gitcfyang/DIY-Sim-Racing-System/SimWheeling/BOM.xlsx

 | 物料 | 型号 | 数量 | 链接 |  | 价格（参考） | 备注
主体 | 碳纤维板加工 |  | 4 |  |  | 160
 | 3d打印件 |  | 若干 |  |  | 30
 | 快拆 | 尺寸适配即可 | 1 |  |  | 50
电子元件 | 按钮（12mm） | pbs-33b | 12 |  |  | 14.4
 | 旋钮（大扭力） | ec11（15mm，200-250g，16脉冲16位，半圆柄） | 5 |  |  | 32.5
 | 微动开关 | d2f-01l（可以使用更便宜的，孔间距6.5mm即可） | 2 |  |  | 5.16
 | 树莓派pico | 无需焊接 | 1 |  |  | 9.75
 | mcp23017模块 |  | 1 |  |  | 10.8
 | 电线 | 24awg硅胶线 | 10m |  |  | 6.8
 | typec数据线 |  | 1 |  |  | 0 | 找一条旧的即可，连接树莓派pico与航空插头
 | 航空插头 | gx12-4p | 1 |  |  | 1.66
 | 赛车弹簧航插线 |  | 1 |  |  | 28 | 闲鱼搜索购买
螺丝螺母（均为内六角，黑色） | m5*65圆头 |  | 3 |  |  |  | 快拆固定螺丝
最好要有冗余！！ | m5*25杯头 |  | 6 |  |  |  | 握把固定螺丝
 | m4*30圆头 |  | 4 |  |  |  | 拨片换挡器固定螺丝
 | m3*18沉头 |  | 6 |  |  |  | 按钮装饰及后盖固定螺丝
 | m2.5*20圆头 |  | 4 |  |  |  | 电路板固定螺丝
 | m4*40 |  | 2 |  | 螺丝总计 | 50 | 换挡拨片用
 | m3*5 |  | 4 |  |  |  | 换挡拨片用
 | m2*14 |  | 4 |  |  |  | 换挡拨片固定微动开关
 | m4*6紧定螺丝 |  | 5 |  |  |  | 旋钮固定螺丝
 | m5尼龙螺母 |  | 若干
 | m4尼龙螺母 |  | 若干
 | m3尼龙螺母 |  | 若干
 | m3普通螺母 |  | 若干
 | m2.5尼龙螺母 |  | 若干
 | m2螺母 |  | 若干
 | 5*9*0.5垫圈 |  | 若干 |  |  |  | 若干用途
其他 | 磁铁 | 直径10，厚度5-10 | >=4，可叠加增强磁性 |  |  | 10 | 换挡拨片用
 | 502 |  |  |  |  | 2 | 粘接磁铁和个别零件
 | 3m双面胶 | 15mm宽，薄款 |  |  |  | 10 | 粘接握把与碳板，填补空隙
 | 羽毛球手胶 |  |  |  |  | 10
 | 其他工具等等
总价 |  |  |  |  |  | 431.07
