gitcfyang/DIY-Sim-Racing-System/SimBase/PrintedComponents/Shell x1.stl

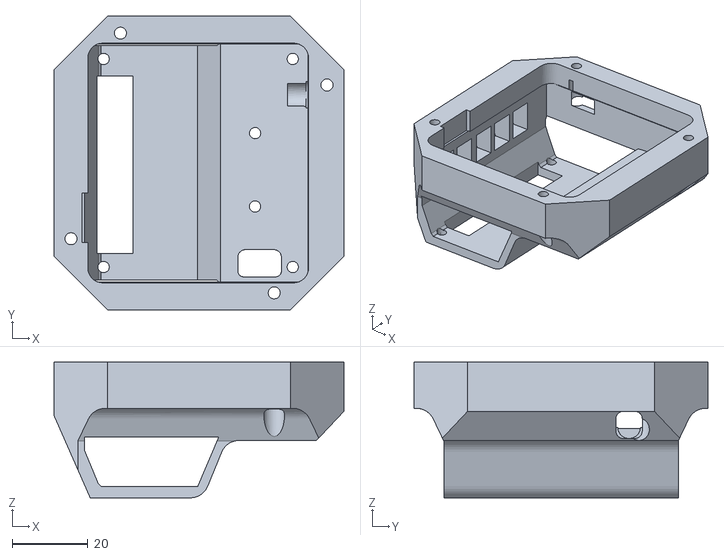
[picture p2: CAD file, 2026-06-08]
SimBase/PrintedComponents/Shell x1.stl
76.7 x 77.7 x 35.9
