gitcfyang/DIY-Sim-Racing-System/SimPedal/MetalComponents/Aluminium Pedal Plates/2mm Throttle Pedal Plate Sheet Metal.DXF

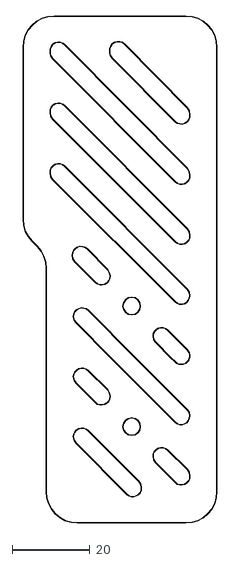
[picture p3: CAD file, 2026-06-08]
SimPedal/MetalComponents/Aluminium Pedal Plates/2mm Throttle Pedal Plate Sheet Metal.DXF
50.0 x 130.8
