gitcfyang/DIY-Sim-Racing-System/SimPedal/MetalComponents/Steel Parts/2mm Foot Plate x1.STEP

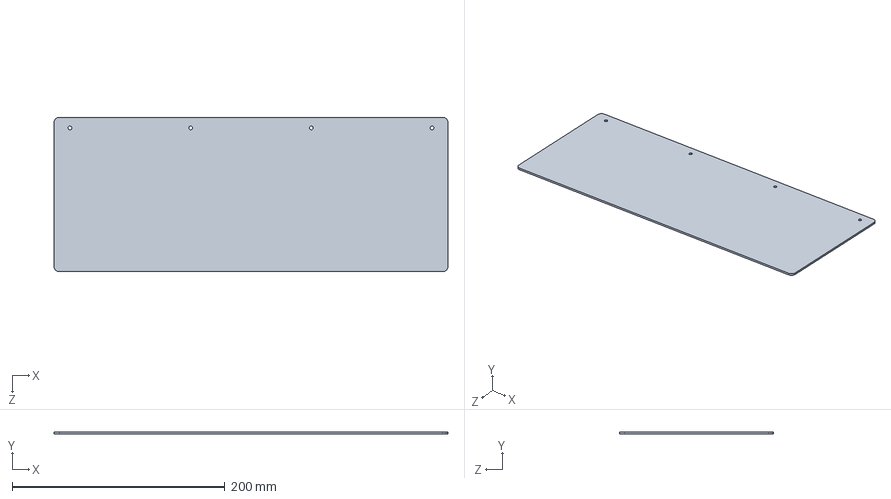
[picture p4: CAD file, 2026-06-08]
SimPedal/MetalComponents/Steel Parts/2mm Foot Plate x1.STEP
370.0 x 2.00 x 145.0 mm
