gitcfyang/DIY-Sim-Racing-System/SimPedal/PrintedComponents/ControlBox控制盒/ShellBase x1.stl

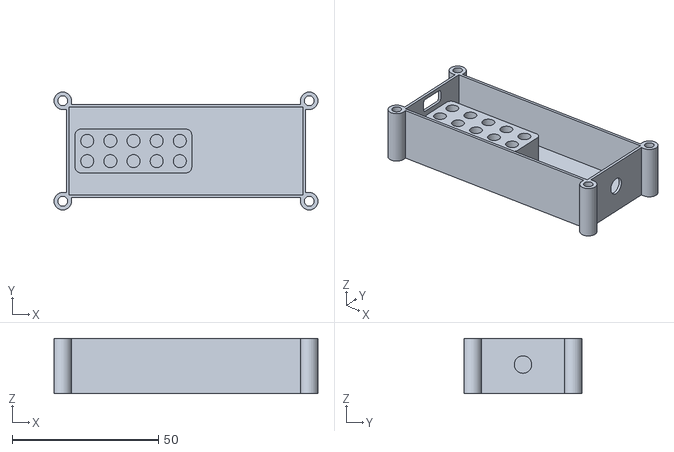
[picture p5: CAD file, 2026-06-08]
SimPedal/PrintedComponents/ControlBox控制盒/ShellBase x1.stl
90.4 x 40.4 x 19.0
