gitcfyang/DIY-Sim-Racing-System/SimPedal/PrintedComponents/Slide Bush x6.STL

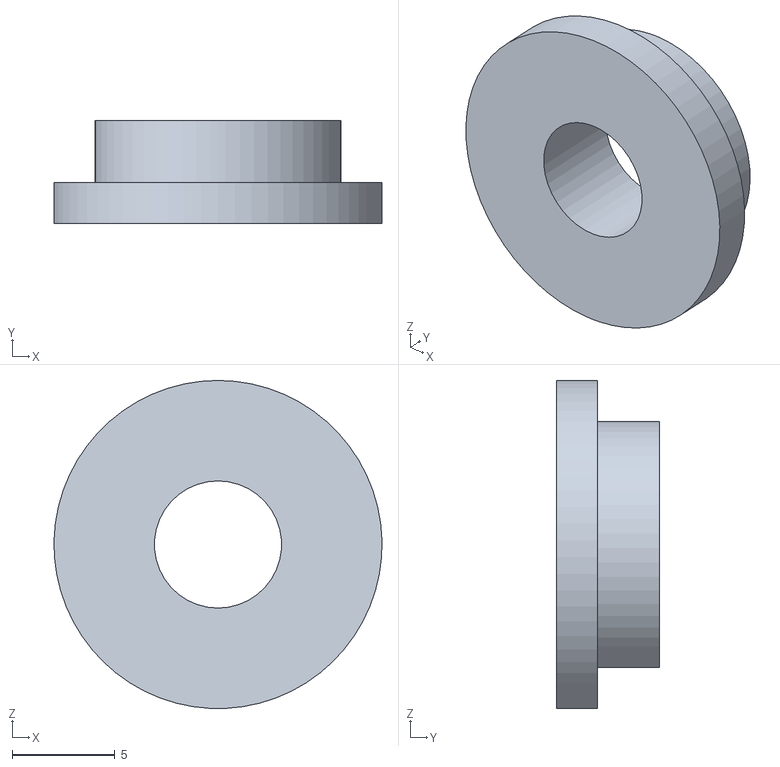
[picture p6: CAD file, 2026-06-08]
SimPedal/PrintedComponents/Slide Bush x6.STL
16.0 x 5.00 x 16.0
