gitcfyang/DIY-Sim-Racing-System/SimWheeling/PrintedComponents/Knob旋钮/Rotary Encoder Knob x5.stl

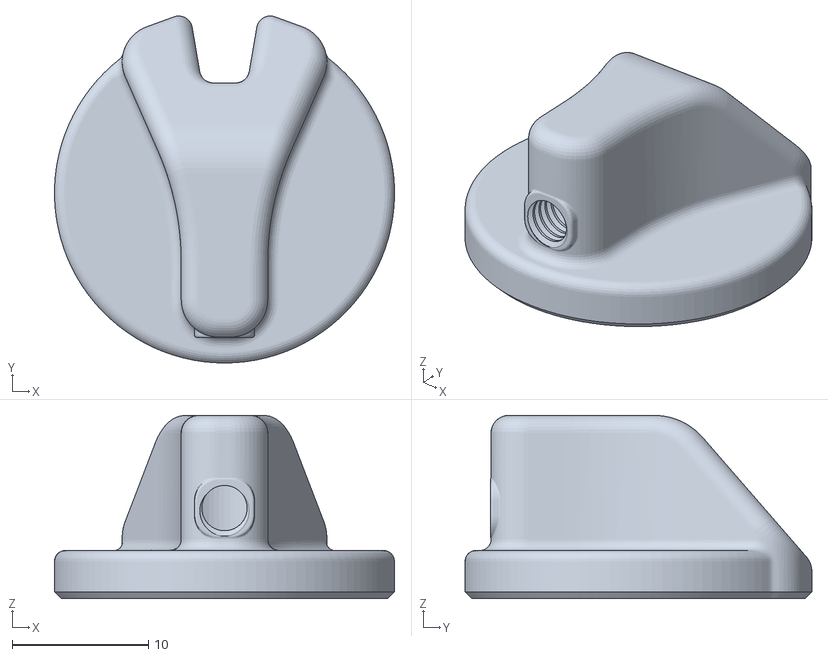
[picture p7: CAD file, 2026-06-08]
SimWheeling/PrintedComponents/Knob旋钮/Rotary Encoder Knob x5.stl
25.0 x 25.5 x 13.5
