gitcfyang/DIY-Sim-Racing-System/SimWheeling/PrintedComponents/Right Rear Button Cover x1.stl

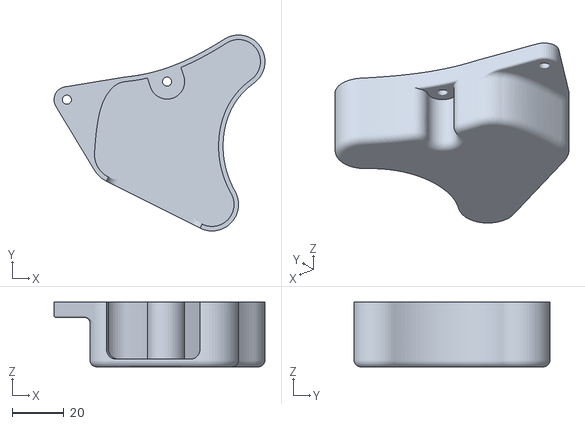
[picture p8: CAD file, 2026-06-08]
SimWheeling/PrintedComponents/Right Rear Button Cover x1.stl
81.5 x 75.7 x 25.0
