gitcfyang/DIY-Sim-Racing-System/SimWheeling/PrintedComponents/Shifter换挡拨片/Shifter Spacer x2.stl

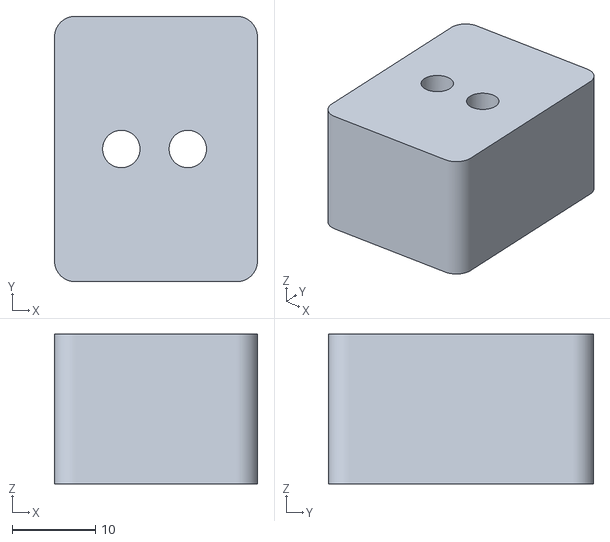
[picture p9: CAD file, 2026-06-08]
SimWheeling/PrintedComponents/Shifter换挡拨片/Shifter Spacer x2.stl
24.4 x 31.9 x 18.0
