gitcfyang/DIY-Sim-Racing-System/SimPedal/MetalComponents/Aluminium Pedal Plates/2mm Brake & Clutch Pedal Plate Sheet Metal.DXF

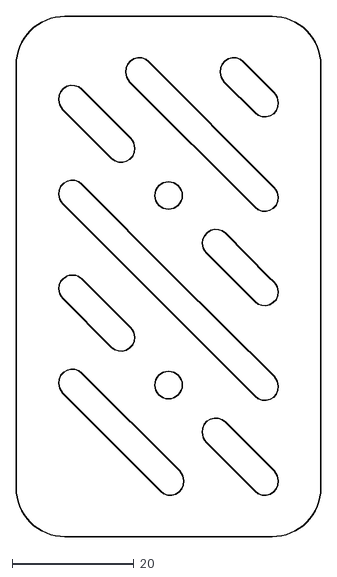
[picture p10: CAD file, 2026-06-08]
SimPedal/MetalComponents/Aluminium Pedal Plates/2mm Brake & Clutch Pedal Plate Sheet Metal.DXF
50.0 x 85.4
