gitcfyang/DIY-Sim-Racing-System/SimPedal/MetalComponents/Steel Parts/3mm Pedal Base Plate x3.STEP

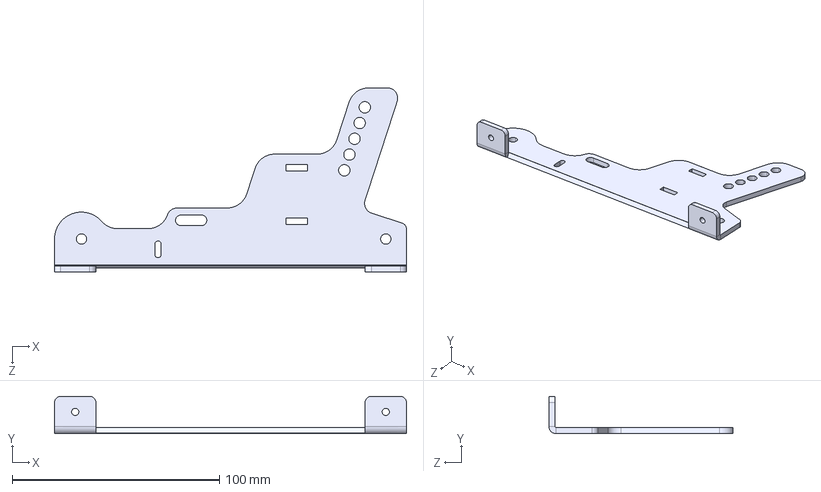
[picture p11: CAD file, 2026-06-08]
SimPedal/MetalComponents/Steel Parts/3mm Pedal Base Plate x3.STEP
170.0 x 18.0 x 89.0 mm
