gitcfyang/DIY-Sim-Racing-System/SimPedal/PrintedComponents/Pedal Mount x2.STL

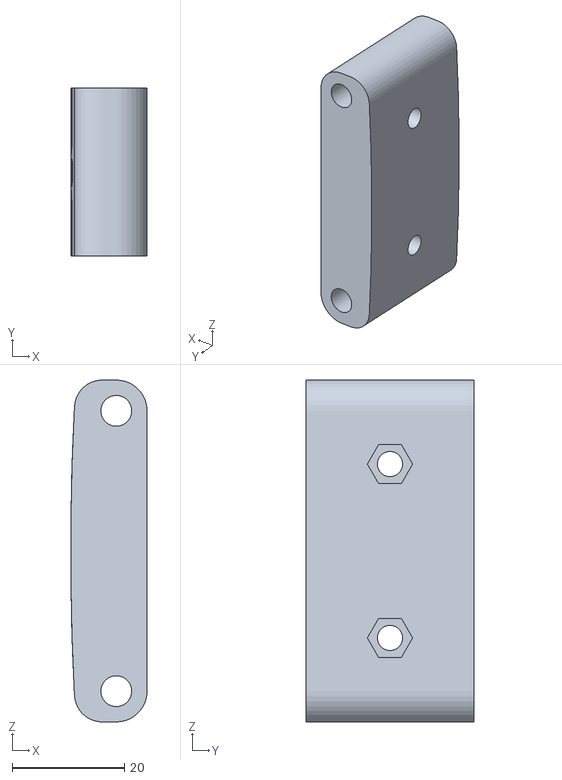
[picture p13: CAD file, 2026-06-08]
SimPedal/PrintedComponents/Pedal Mount x2.STL
13.6 x 30.0 x 61.0
