gitcfyang/DIY-Sim-Racing-System/SimWheeling/PrintedComponents/Grip Right Front x1.stl

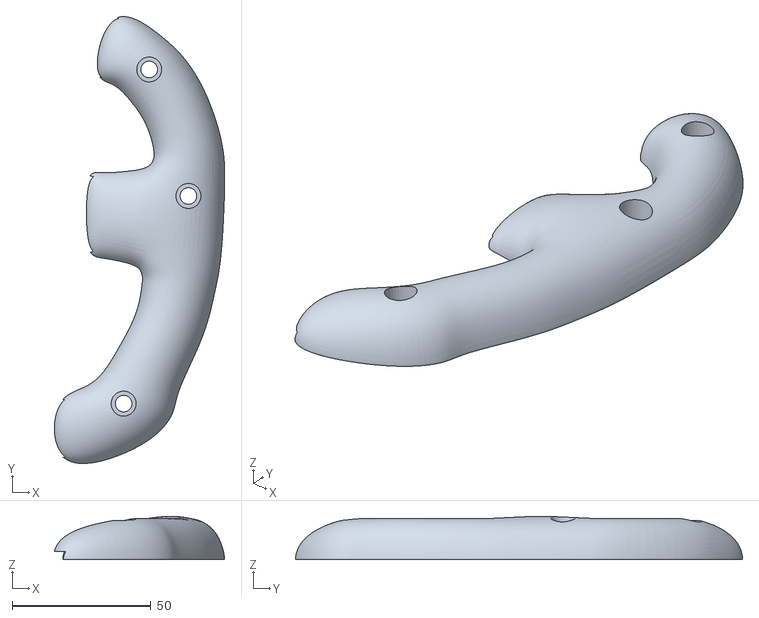
[picture p14: CAD file, 2026-06-08]
SimWheeling/PrintedComponents/Grip Right Front x1.stl
61.3 x 160.8 x 15.6
