gitcfyang/DIY-Sim-Racing-System/SimWheeling/PrintedComponents/Shifter换挡拨片/Base Top x2.stl

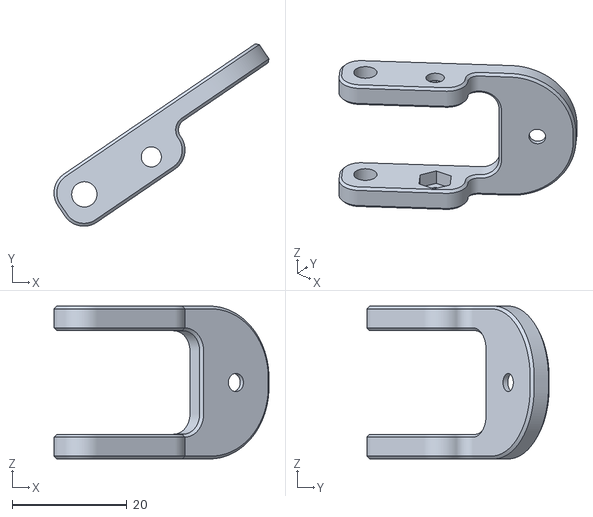
[picture p15: CAD file, 2026-06-08]
SimWheeling/PrintedComponents/Shifter换挡拨片/Base Top x2.stl
37.4 x 31.7 x 26.6
