gitcfyang/DIY-Sim-Racing-System/SimPedal/PrintedComponents/Pedal Bearing Mount x3.STL

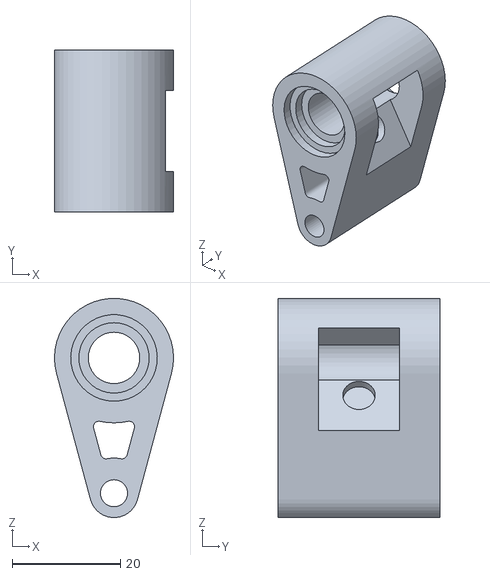
[picture p16: CAD file, 2026-06-08]
SimPedal/PrintedComponents/Pedal Bearing Mount x3.STL
22.0 x 30.0 x 40.5
