gitcfyang/DIY-Sim-Racing-System/SimWheeling/PrintedComponents/Hub Spacer x1.stl

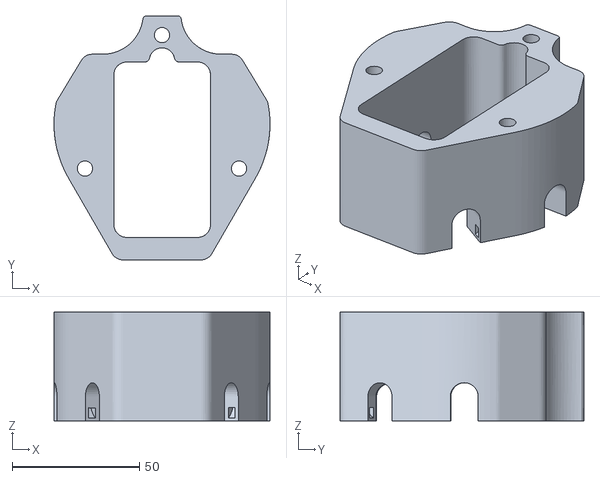
[picture p17: CAD file, 2026-06-08]
SimWheeling/PrintedComponents/Hub Spacer x1.stl
85.0 x 96.0 x 42.8
