gitcfyang/DIY-Sim-Racing-System/SimWheeling/PrintedComponents/Shifter换挡拨片/Lever x2.stl

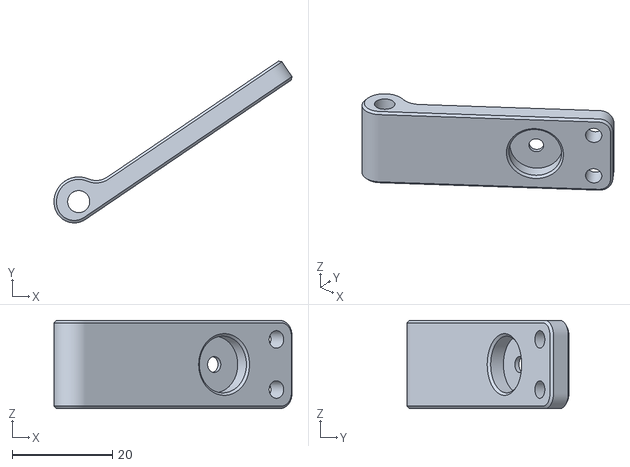
[picture p18: CAD file, 2026-06-08]
SimWheeling/PrintedComponents/Shifter换挡拨片/Lever x2.stl
47.4 x 32.3 x 17.6
