gitcfyang/DIY-Sim-Racing-System/SimPedal/MetalComponents/Steel Parts/3mm Load Cell Mounting Plate x2.STEP

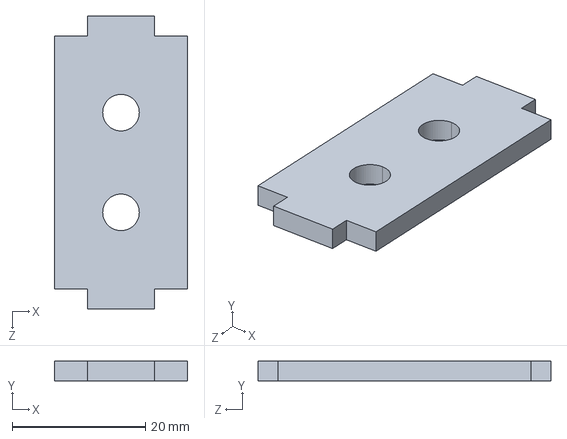
[picture p19: CAD file, 2026-06-08]
SimPedal/MetalComponents/Steel Parts/3mm Load Cell Mounting Plate x2.STEP
20.0 x 3.00 x 44.0 mm
