gitcfyang/DIY-Sim-Racing-System/SimPedal/PrintedComponents/Pedal Spacer x3.STL

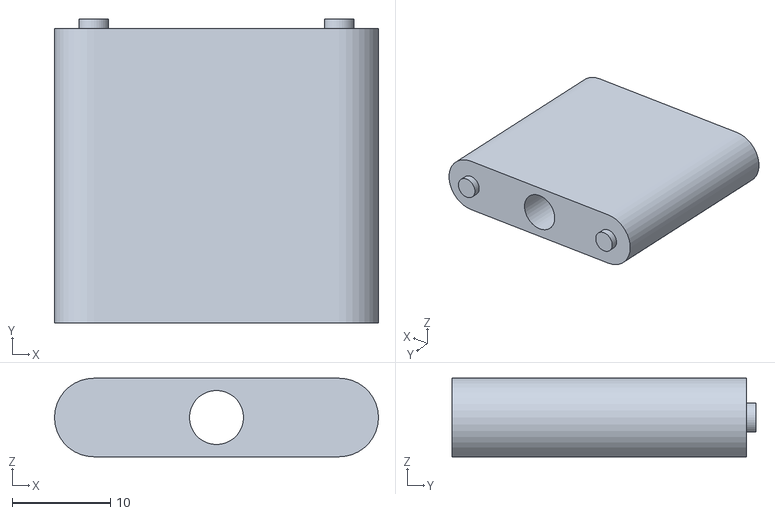
[picture p20: CAD file, 2026-06-08]
SimPedal/PrintedComponents/Pedal Spacer x3.STL
33.0 x 31.0 x 8.00
