gitcfyang/DIY-Sim-Racing-System/SimWheeling/PrintedComponents/Right Button Insert x1.stl

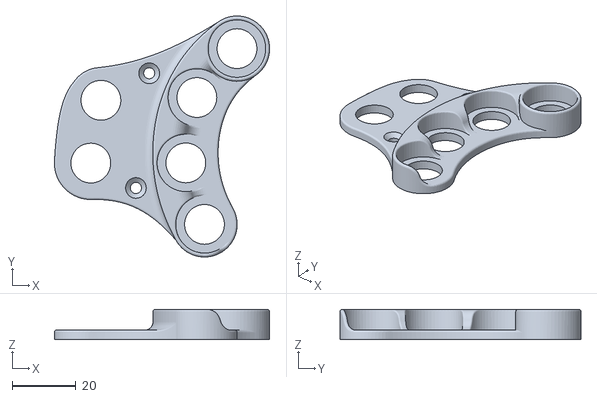
[picture p21: CAD file, 2026-06-08]
SimWheeling/PrintedComponents/Right Button Insert x1.stl
67.6 x 75.7 x 9.50
