gitcfyang/DIY-Sim-Racing-System/SimWheeling/PrintedComponents/Shifter换挡拨片/Base Bottom x2.stl

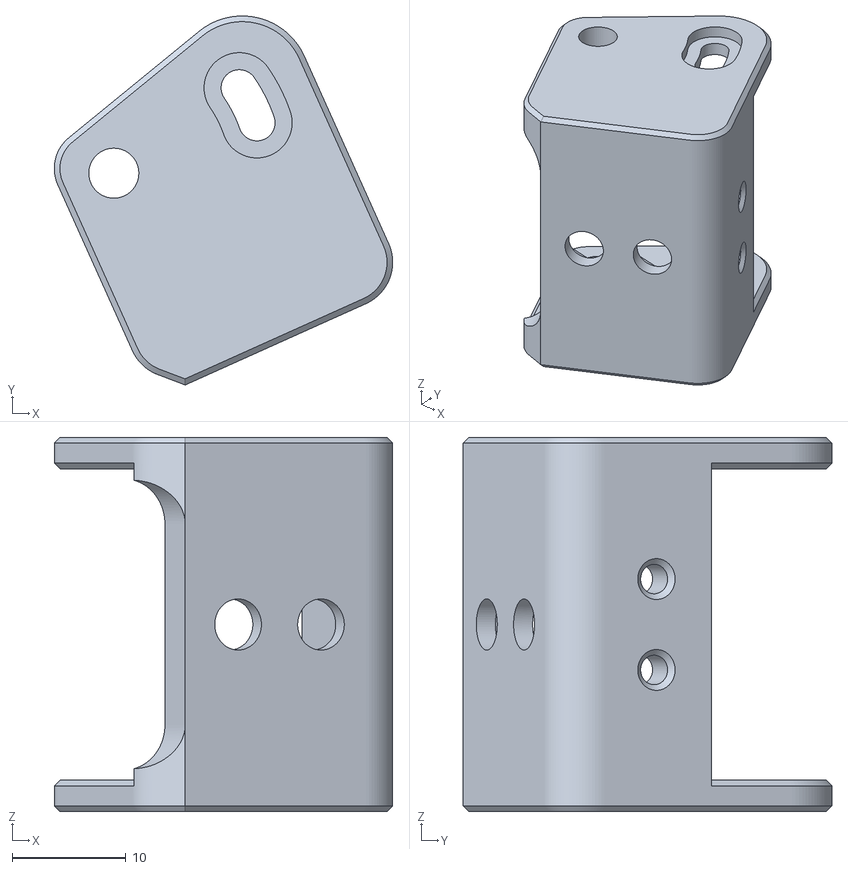
[picture p22: CAD file, 2026-06-08]
SimWheeling/PrintedComponents/Shifter换挡拨片/Base Bottom x2.stl
29.8 x 32.5 x 32.9
