gitcfyang/DIY-Sim-Racing-System/SimPedal/MetalComponents/Steel Parts/3mm Brake Spring Back Plate x1.STEP

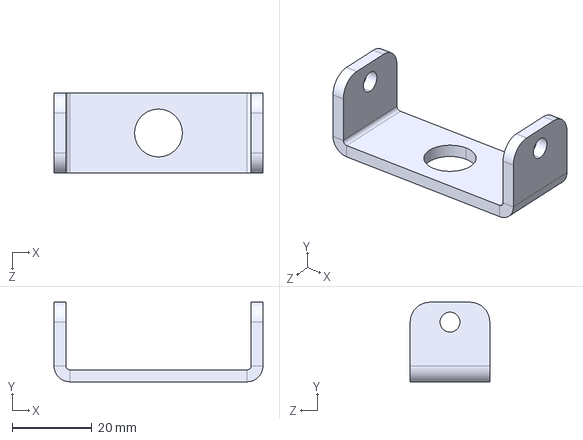
[picture p23: CAD file, 2026-06-08]
SimPedal/MetalComponents/Steel Parts/3mm Brake Spring Back Plate x1.STEP
52.5 x 20.0 x 20.0 mm
