gitcfyang/DIY-Sim-Racing-System/SimPedal/PrintedComponents/Foot Rest Support x1.stl

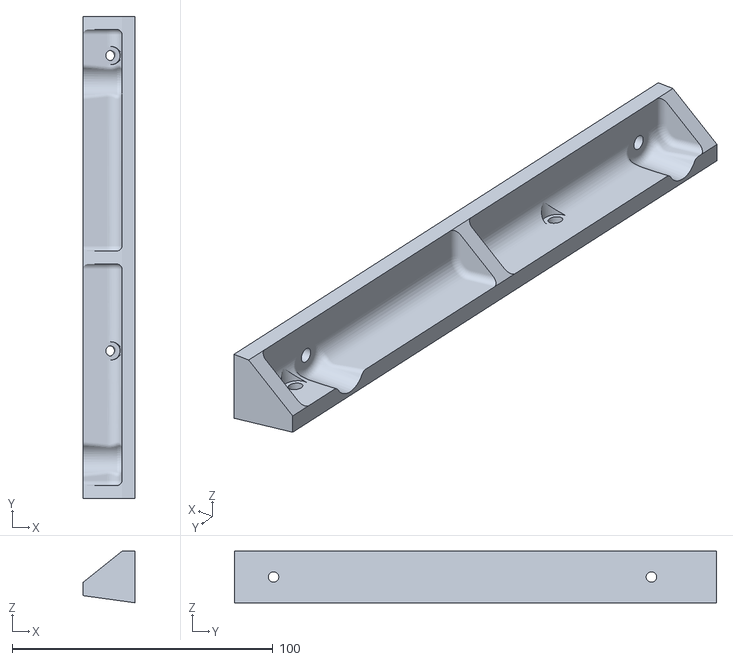
[picture p24: CAD file, 2026-06-08]
SimPedal/PrintedComponents/Foot Rest Support x1.stl
20.0 x 185.0 x 19.8
