gitcfyang/DIY-Sim-Racing-System/SimPedal/MetalComponents/Steel Parts/3mm Angled Load Cell Bracket x1.STEP

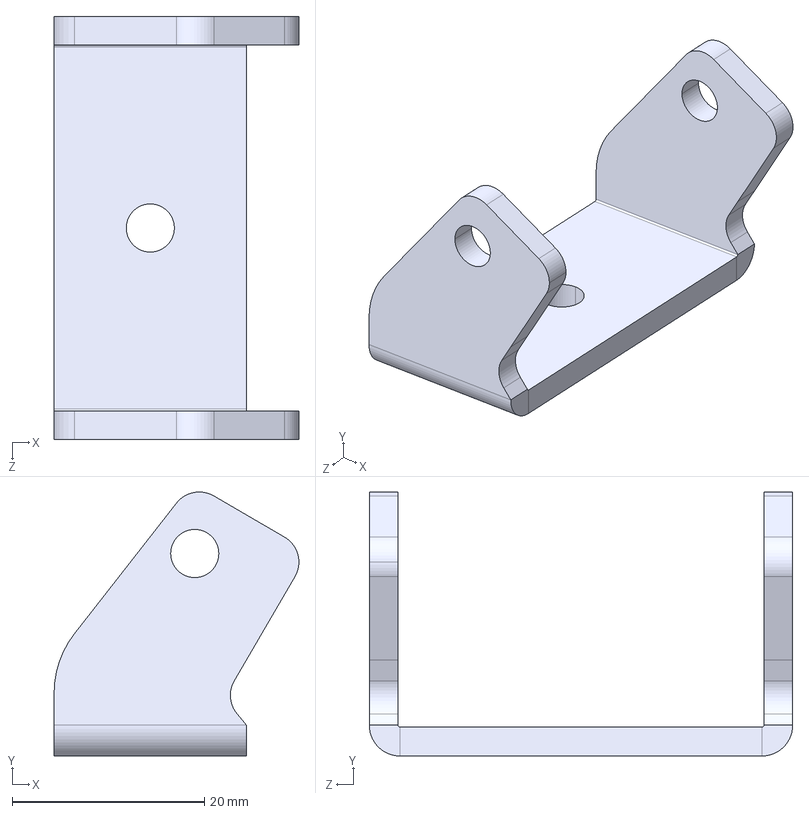
[picture p25: CAD file, 2026-06-08]
SimPedal/MetalComponents/Steel Parts/3mm Angled Load Cell Bracket x1.STEP
25.4 x 27.4 x 44.0 mm
