gitcfyang/DIY-Sim-Racing-System/SimPedal/PrintedComponents/Limit Stop Tube x6.STL

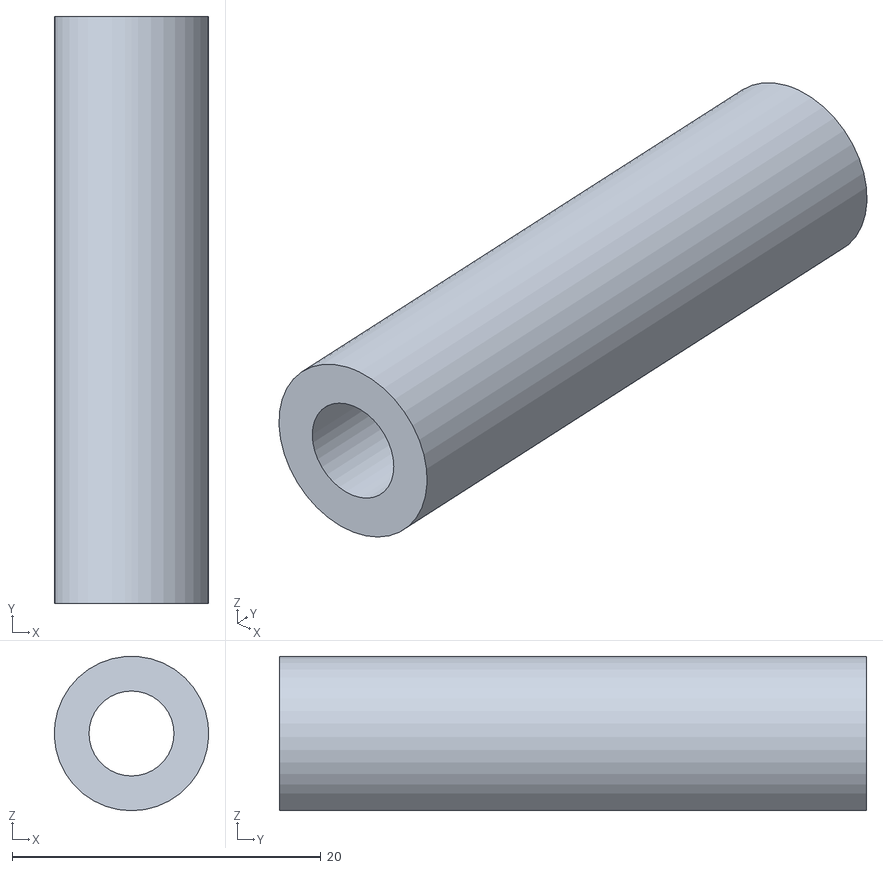
[picture p26: CAD file, 2026-06-08]
SimPedal/PrintedComponents/Limit Stop Tube x6.STL
9.99 x 38.0 x 10.0
