gitcfyang/DIY-Sim-Racing-System/SimWheeling/PrintedComponents/Grip Right Rear x1.stl

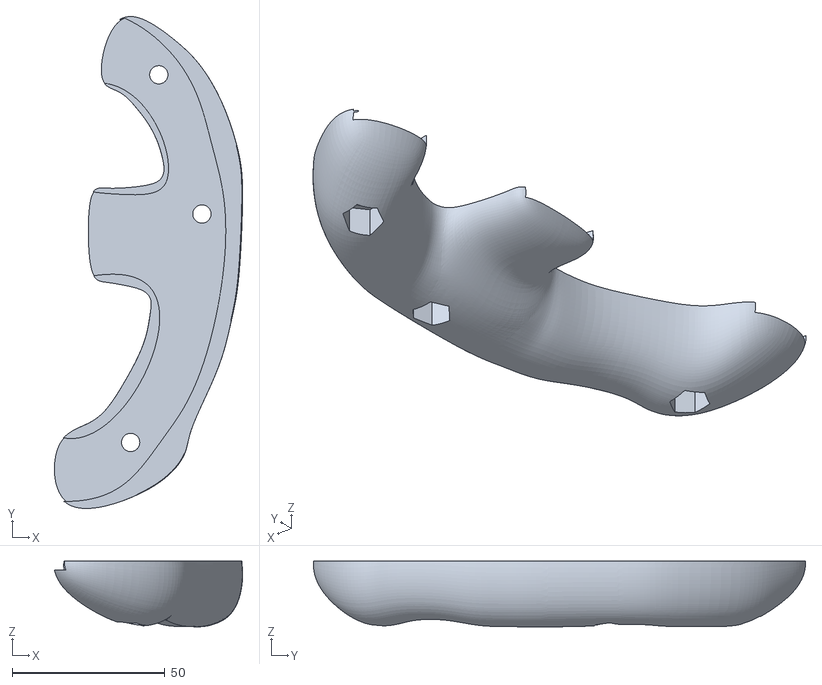
[picture p27: CAD file, 2026-06-08]
SimWheeling/PrintedComponents/Grip Right Rear x1.stl
61.5 x 160.9 x 21.5
