gitcfyang/DIY-Sim-Racing-System/SimPedal/MetalComponents/Steel Parts/3mm Pedal Side Plate x6.STEP

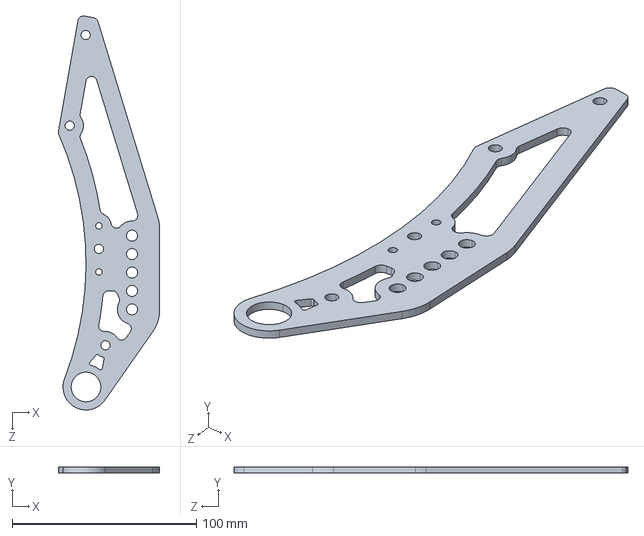
[picture p28: CAD file, 2026-06-08]
SimPedal/MetalComponents/Steel Parts/3mm Pedal Side Plate x6.STEP
55.0 x 3.00 x 214.0 mm
