gitcfyang/DIY-Sim-Racing-System/SimPedal/PrintedComponents/Clevis Spacer x12.STL

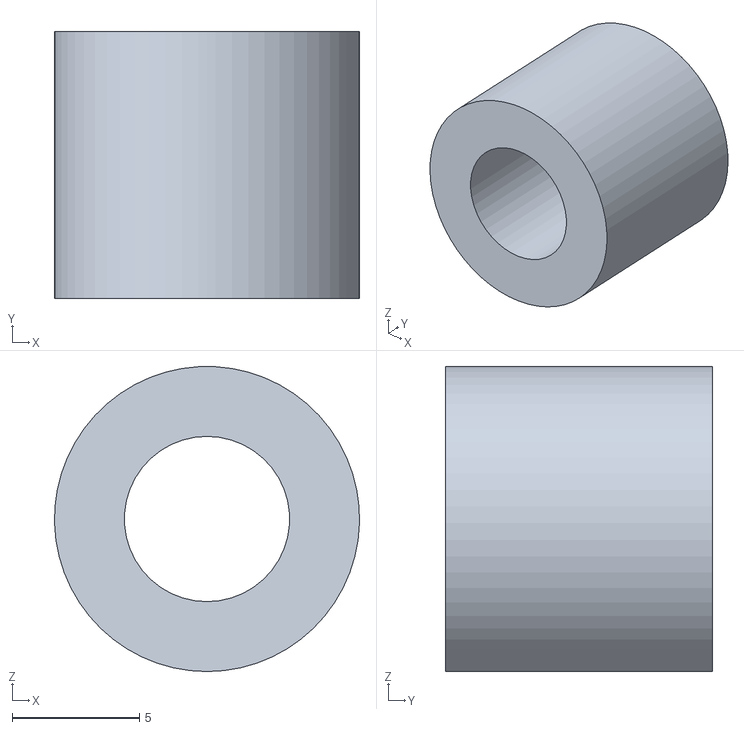
[picture p29: CAD file, 2026-06-08]
SimPedal/PrintedComponents/Clevis Spacer x12.STL
12.0 x 10.5 x 12.0
