gitcfyang/DIY-Sim-Racing-System/SimPedal/MetalComponents/Steel Parts/3mm Spring Back Plate x2.STEP

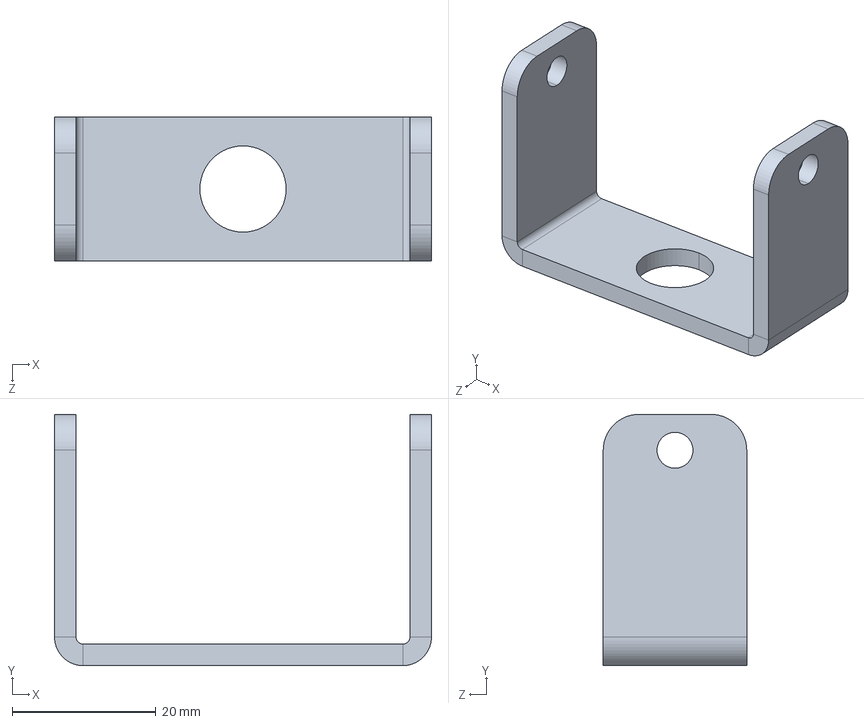
[picture p30: CAD file, 2026-06-08]
SimPedal/MetalComponents/Steel Parts/3mm Spring Back Plate x2.STEP
52.5 x 35.0 x 20.0 mm
