gitcfyang/DIY-Sim-Racing-System/SimPedal/PrintedComponents/Pedal Mount Throttle x1.STL

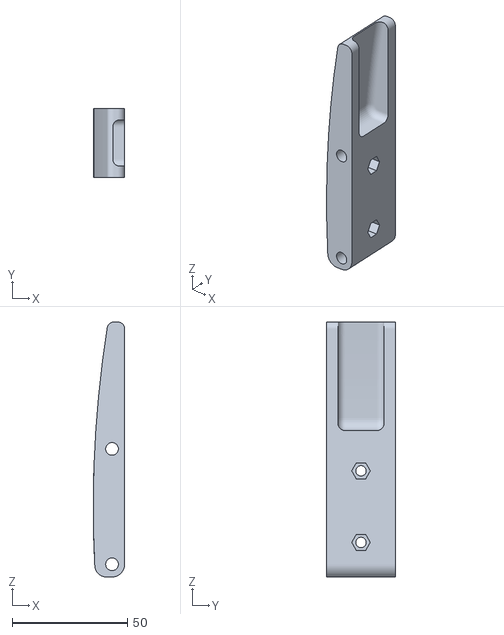
[picture p31: CAD file, 2026-06-08]
SimPedal/PrintedComponents/Pedal Mount Throttle x1.STL
13.6 x 30.0 x 110.5
