gitcfyang/DIY-Sim-Racing-System/SimPedal/PrintedComponents/Hall Effect Mount x2.STL

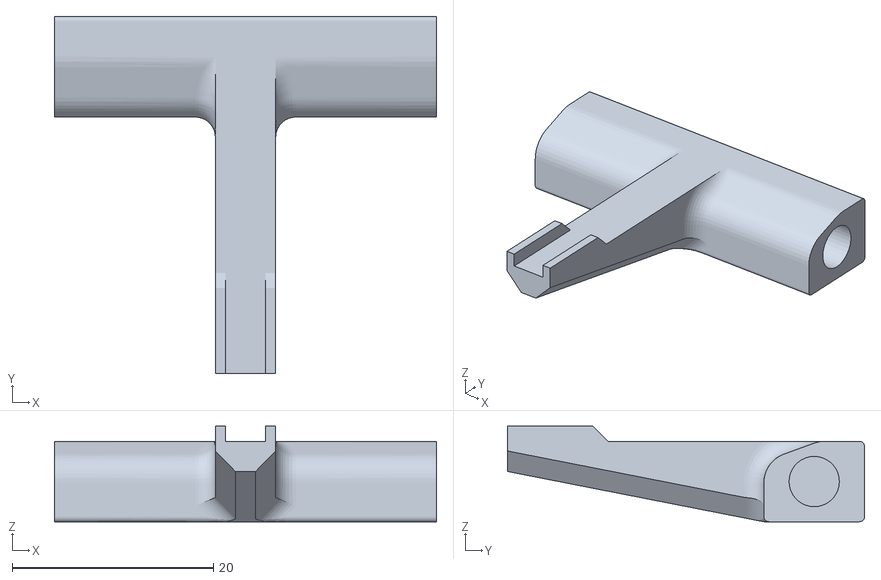
[picture p32: CAD file, 2026-06-08]
SimPedal/PrintedComponents/Hall Effect Mount x2.STL
38.0 x 35.5 x 9.50
