gitcfyang/DIY-Sim-Racing-System/SimPedal/PrintedComponents/Pedal Bearing Crush Tube x3.STL

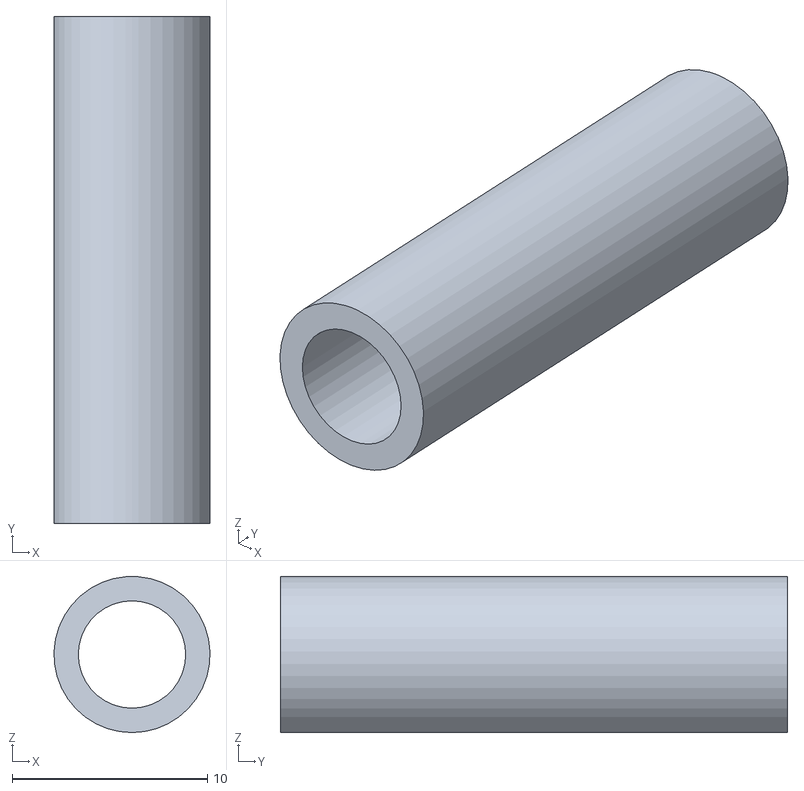
[picture p33: CAD file, 2026-06-08]
SimPedal/PrintedComponents/Pedal Bearing Crush Tube x3.STL
7.99 x 26.0 x 8.00
