gitcfyang/DIY-Sim-Racing-System/SimWheeling/PrintedComponents/PicoBase x1.stl

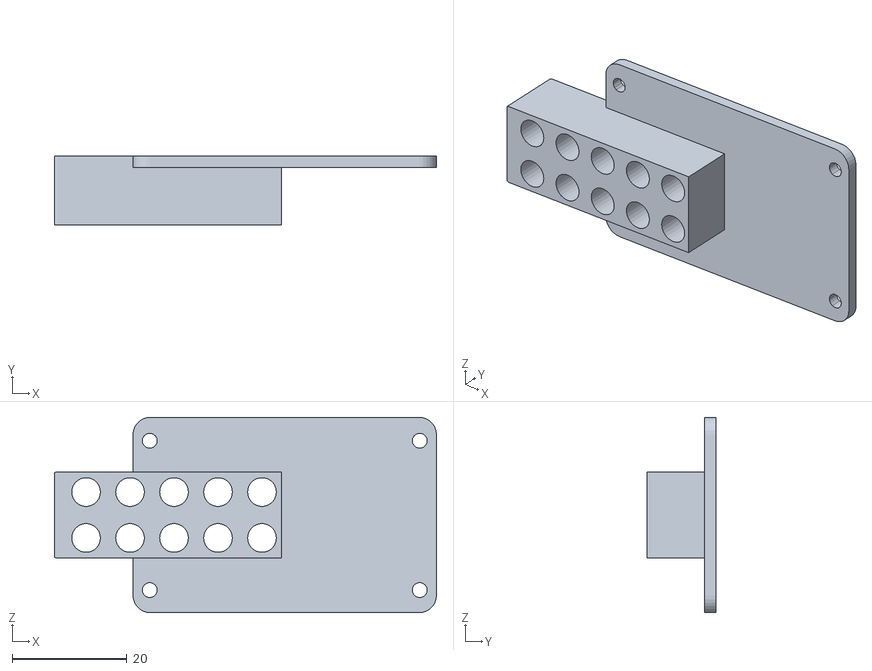
[picture p34: CAD file, 2026-06-08]
SimWheeling/PrintedComponents/PicoBase x1.stl
66.5 x 12.0 x 34.0
