gitcfyang/DIY-Sim-Racing-System/SimPedal/PrintedComponents/Spring Seat x6.STL

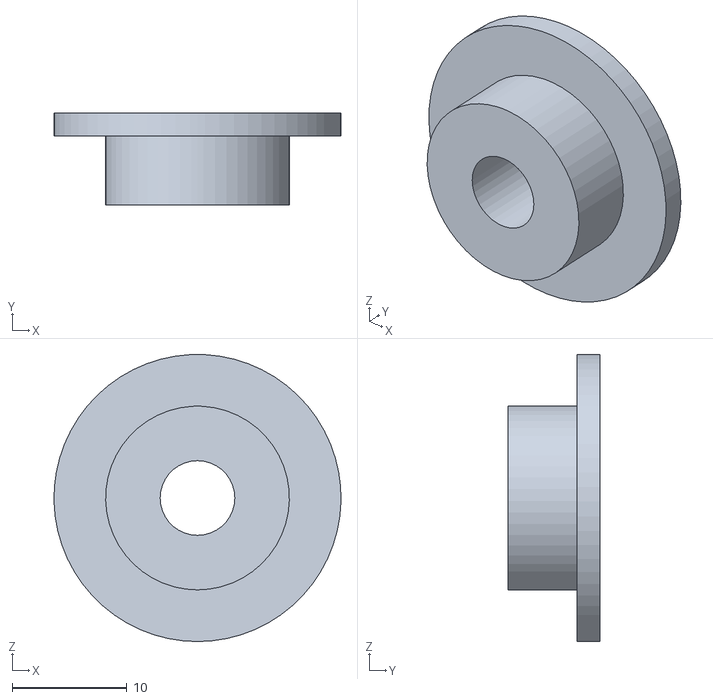
[picture p35: CAD file, 2026-06-08]
SimPedal/PrintedComponents/Spring Seat x6.STL
25.0 x 8.00 x 25.0
