gitcfyang/DIY-Sim-Racing-System/SimPedal/PrintedComponents/Brake pedal form x1.STL

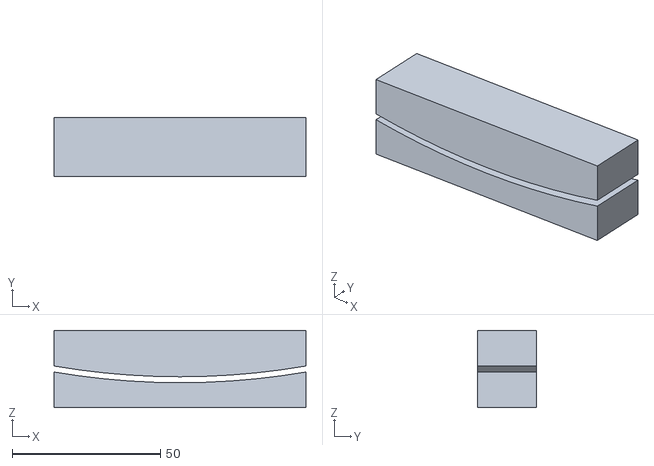
[picture p36: CAD file, 2026-06-08]
SimPedal/PrintedComponents/Brake pedal form x1.STL
85.0 x 20.0 x 26.0
