gitcfyang/DIY-Sim-Racing-System/(list of files, cad)

Other CAD files:
SimWheeling/CarbonfiberComponents/Drawing4.dwg
SimWheeling/CarbonfiberComponents/Drawing3.dwg
SimPedal/MetalComponents/Steel Parts/3mm Pedal Base Plate Mirrored x3.STEP
SimWheeling/CarbonfiberComponents/Drawing1.dwg
SimWheeling/CarbonfiberComponents/Drawing2.dwg
SimWheeling/PrintedComponents/Left Rear Button Cover x1.stl
SimPedal/PrintedComponents/Foot Rest Support (Mirror pair) x1.STL
SimWheeling/PrintedComponents/Grip Left Front x1.stl
SimWheeling/PrintedComponents/Grip Left Rear x1.stl
SimWheeling/PrintedComponents/Left Button Insert x1.stl
SimPedal/MetalComponents/Steel Parts/2mm Foot Plate x1.DXF
SimPedal/MetalComponents/Steel Parts/3mm Angled Load Cell Bracket x1.DXF
SimPedal/MetalComponents/Steel Parts/3mm Brake Spring Back Plate x1.DXF
SimPedal/MetalComponents/Steel Parts/3mm Load Cell Mounting Plate x2.DXF
SimPedal/MetalComponents/Steel Parts/3mm Pedal Base Plate Mirrored x3.DXF
SimPedal/MetalComponents/Steel Parts/3mm Pedal Base Plate x3.DXF
SimPedal/MetalComponents/Steel Parts/3mm Pedal Side Plate x6.DXF
SimPedal/MetalComponents/Steel Parts/3mm Spring Back Plate x2.DXF
SimPedal/ShellBase.CATPart
SimWheeling/PrintedComponents/MCP23017Base x1.stl
