gitcfyang/DIY-Sim-Racing-System/(commit log)

2026-06-11 add bom xlsx
    [BOM.xlsx]
2026-06-11 update wheeling bom
    [BOM.xlsx]
2026-06-11 update wheeling readme
2026-06-11 update gitignore file
    [BOM.xlsx]
